lw1414/arc-fault-project/Block Diagrams/arcfault-firmware.png

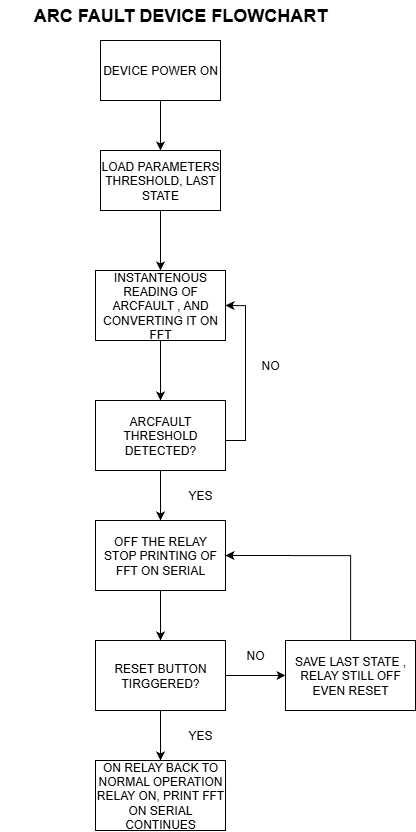
Block Diagrams/arcfault-firmware.png
