lw1414/arc-fault-project/Block Diagrams/arcfault-hardware block.png

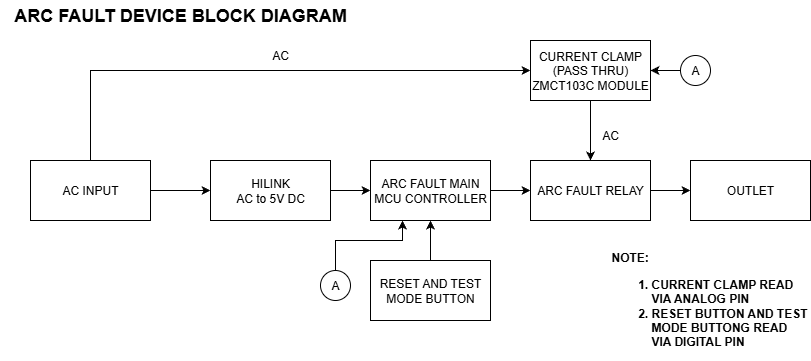
Block Diagrams/arcfault-hardware block.png
