lw1414/arc-fault-project/Block Diagrams/arcfault-physical connection on AC.png

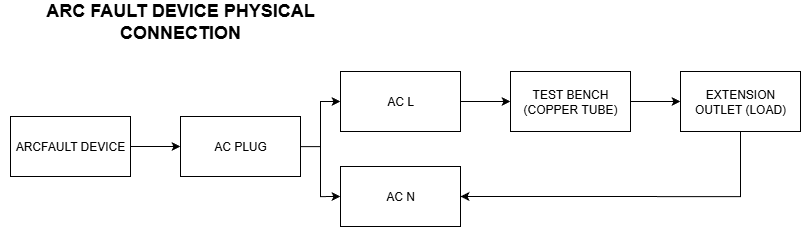
Block Diagrams/arcfault-physical connection on AC.png
