lw1414/arc-fault-project/Hardware/arc-fault - relay/EASYEDA_MODELS/RELAY-TH_L19.2-W15.6-H15.8.step

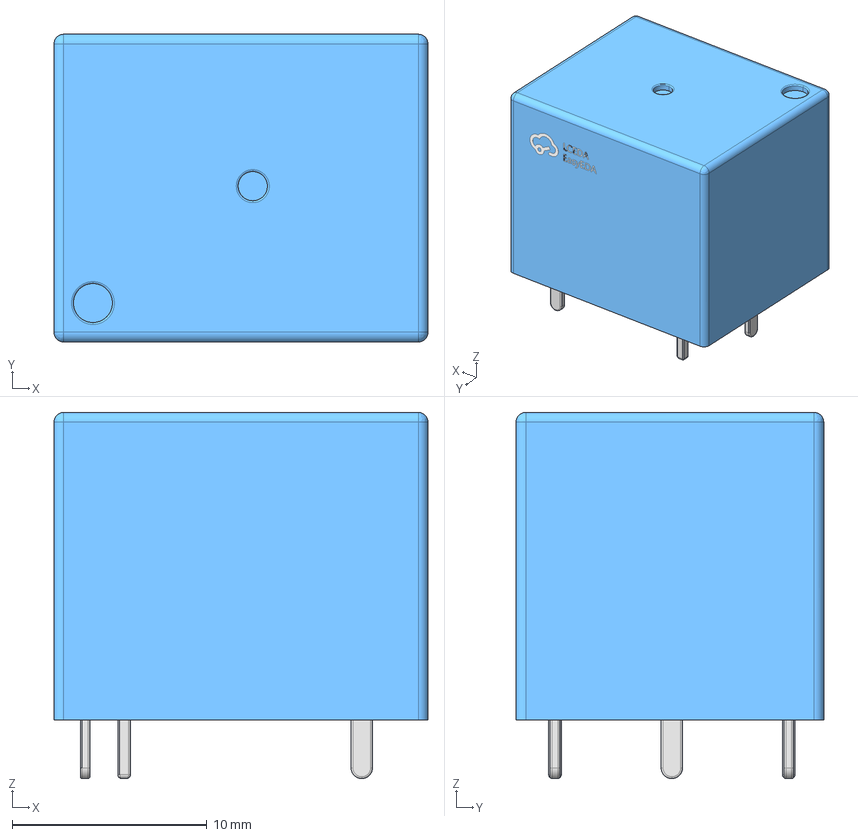
[picture p4: CAD file, 2025-11-20]
Hardware/arc-fault - relay/EASYEDA_MODELS/RELAY-TH_L19.2-W15.6-H15.8.step
19.2 x 15.8 x 18.8 mm
