lw1414/arc-fault-project/Hardware/arc-fault-main/EASYEDA_MODELS/PWRM-TH_HLK-5M05.step

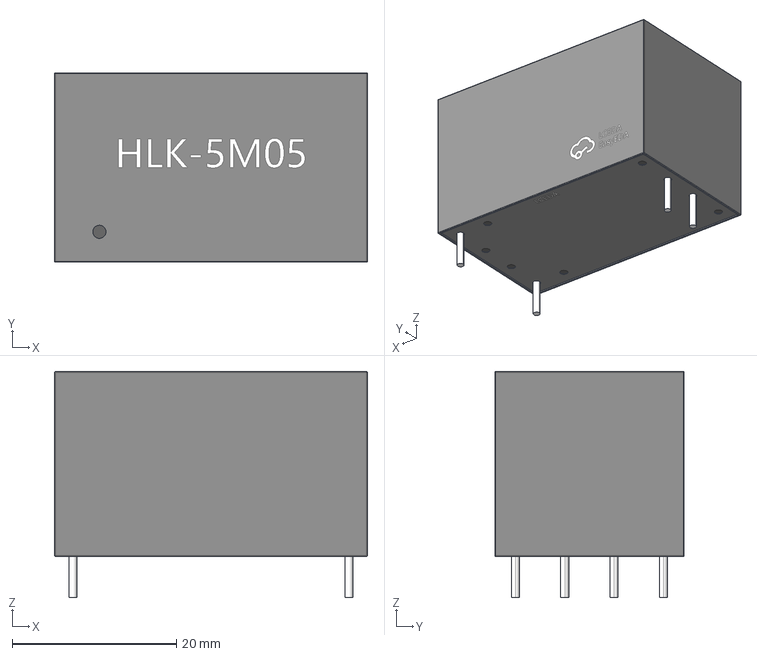
[picture p5: CAD file, 2025-11-20]
Hardware/arc-fault-main/EASYEDA_MODELS/PWRM-TH_HLK-5M05.step
38.1 x 23.1 x 27.5 mm
