lw1414/arc-fault-project/Hardware/arc-fault-miniboard/arc-fault-miniboard-UPDATED.step

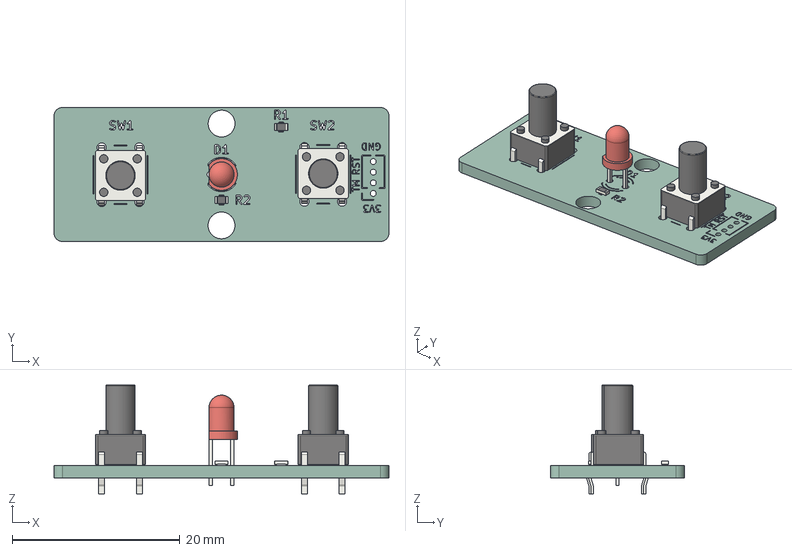
[picture p6: CAD file, 2025-11-20]
Hardware/arc-fault-miniboard/arc-fault-miniboard-UPDATED.step
40.0 x 16.0 x 13.0 mm
SW_PUSH_6mm_H9.5mm x 2
R_0603_1608Metric x 2
LED_D3.0mm
arc-fault-miniboard_silkscreen
arc-fault-miniboard_PCB
