lw1414/arc-fault-project/Hardware/arc-fault-main/EASYEDA_MODELS/USB-C-SMD_TYPE-C16PIN.step

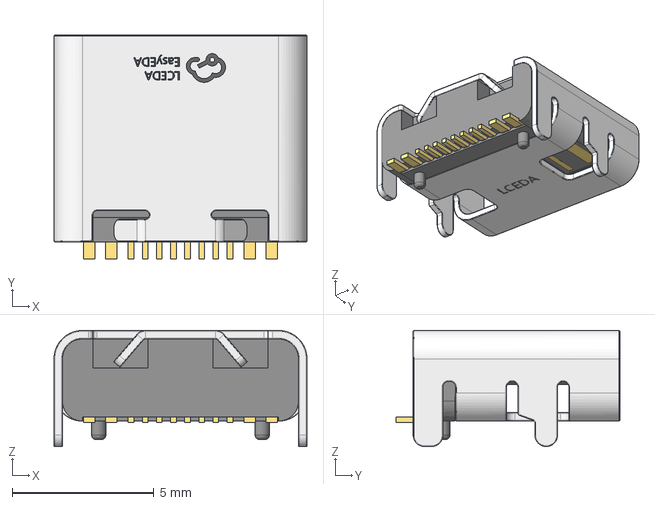
[picture p7: CAD file, 2025-11-20]
Hardware/arc-fault-main/EASYEDA_MODELS/USB-C-SMD_TYPE-C16PIN.step
8.94 x 7.90 x 4.10 mm
