lw1414/arc-fault-project/Hardware/arc-fault - relay/EASYEDA_MODELS/PC817X2NIP1B_SHP.step

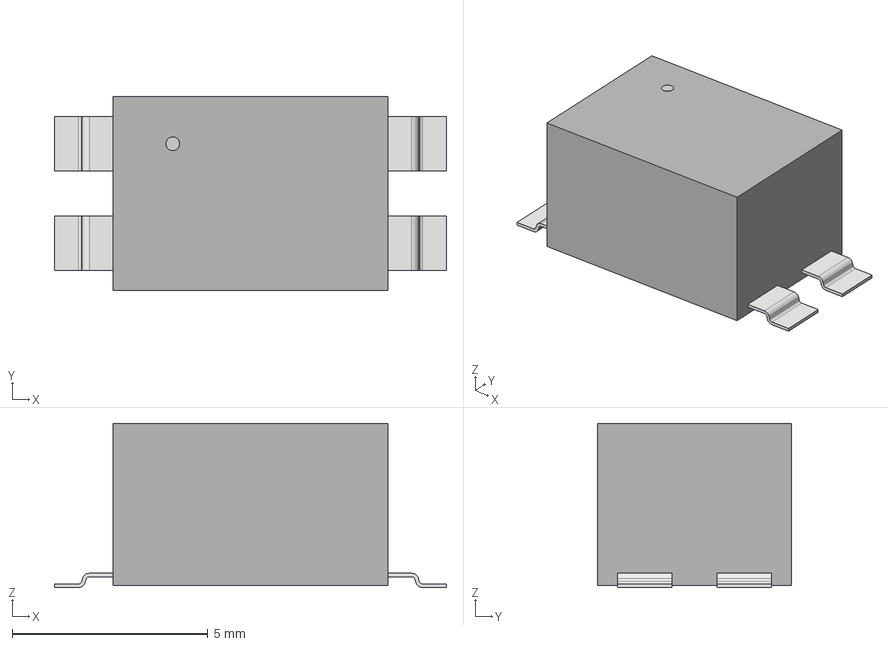
[picture p9: CAD file, 2025-11-20]
Hardware/arc-fault - relay/EASYEDA_MODELS/PC817X2NIP1B_SHP.step
10.0 x 4.95 x 4.19 mm
