lw1414/arc-fault-project/Hardware/arc-fault-main/EASYEDA_MODELS/RELAY-TH_G6A-274P-ST-US-DC5.step

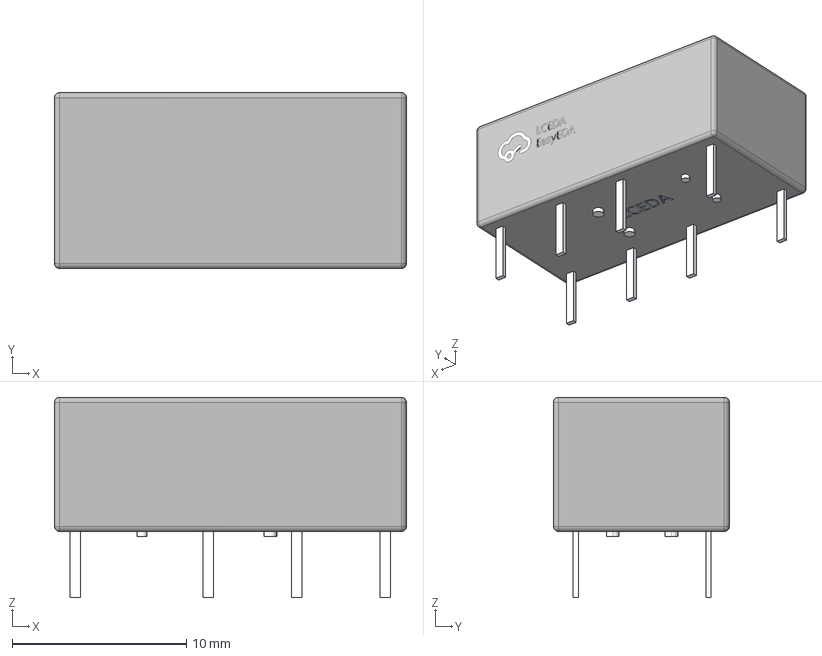
[picture p10: CAD file, 2025-11-20]
Hardware/arc-fault-main/EASYEDA_MODELS/RELAY-TH_G6A-274P-ST-US-DC5.step
20.2 x 10.1 x 11.5 mm
