lw1414/arc-fault-project/(list of files, cad)

Other CAD files:
Hardware/arc-fault-main/EASYEDA_MODELS/RELAY-TH_L19.2-W15.6-H15.8.step
