lw1414/arc-fault-project/Schematic/arc-fault -buttons-schematic.pdf

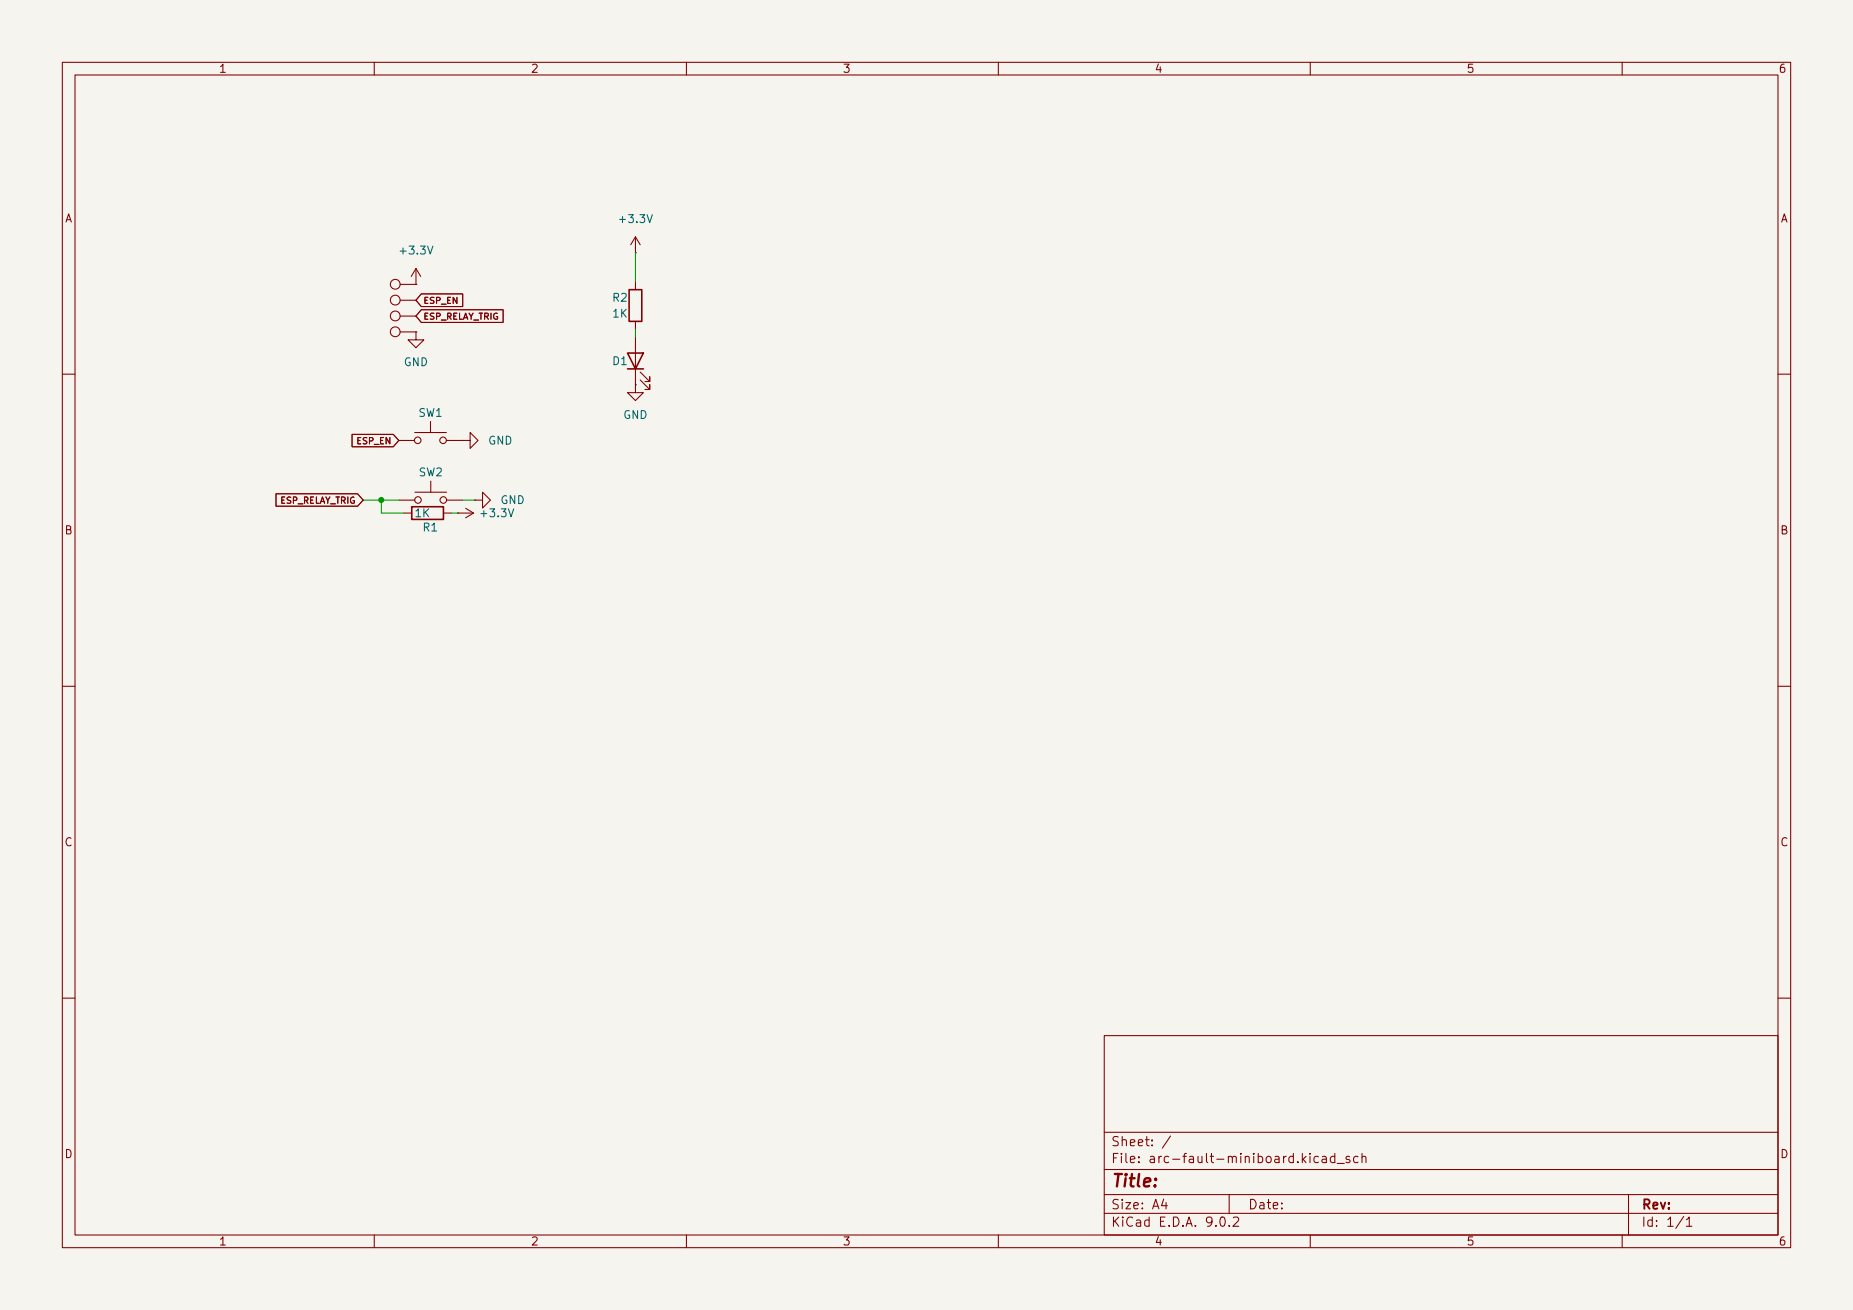
[picture p17: page 1]
