lw1414/arc-fault-project/Schematic/arc-fault -relay-schematic.pdf

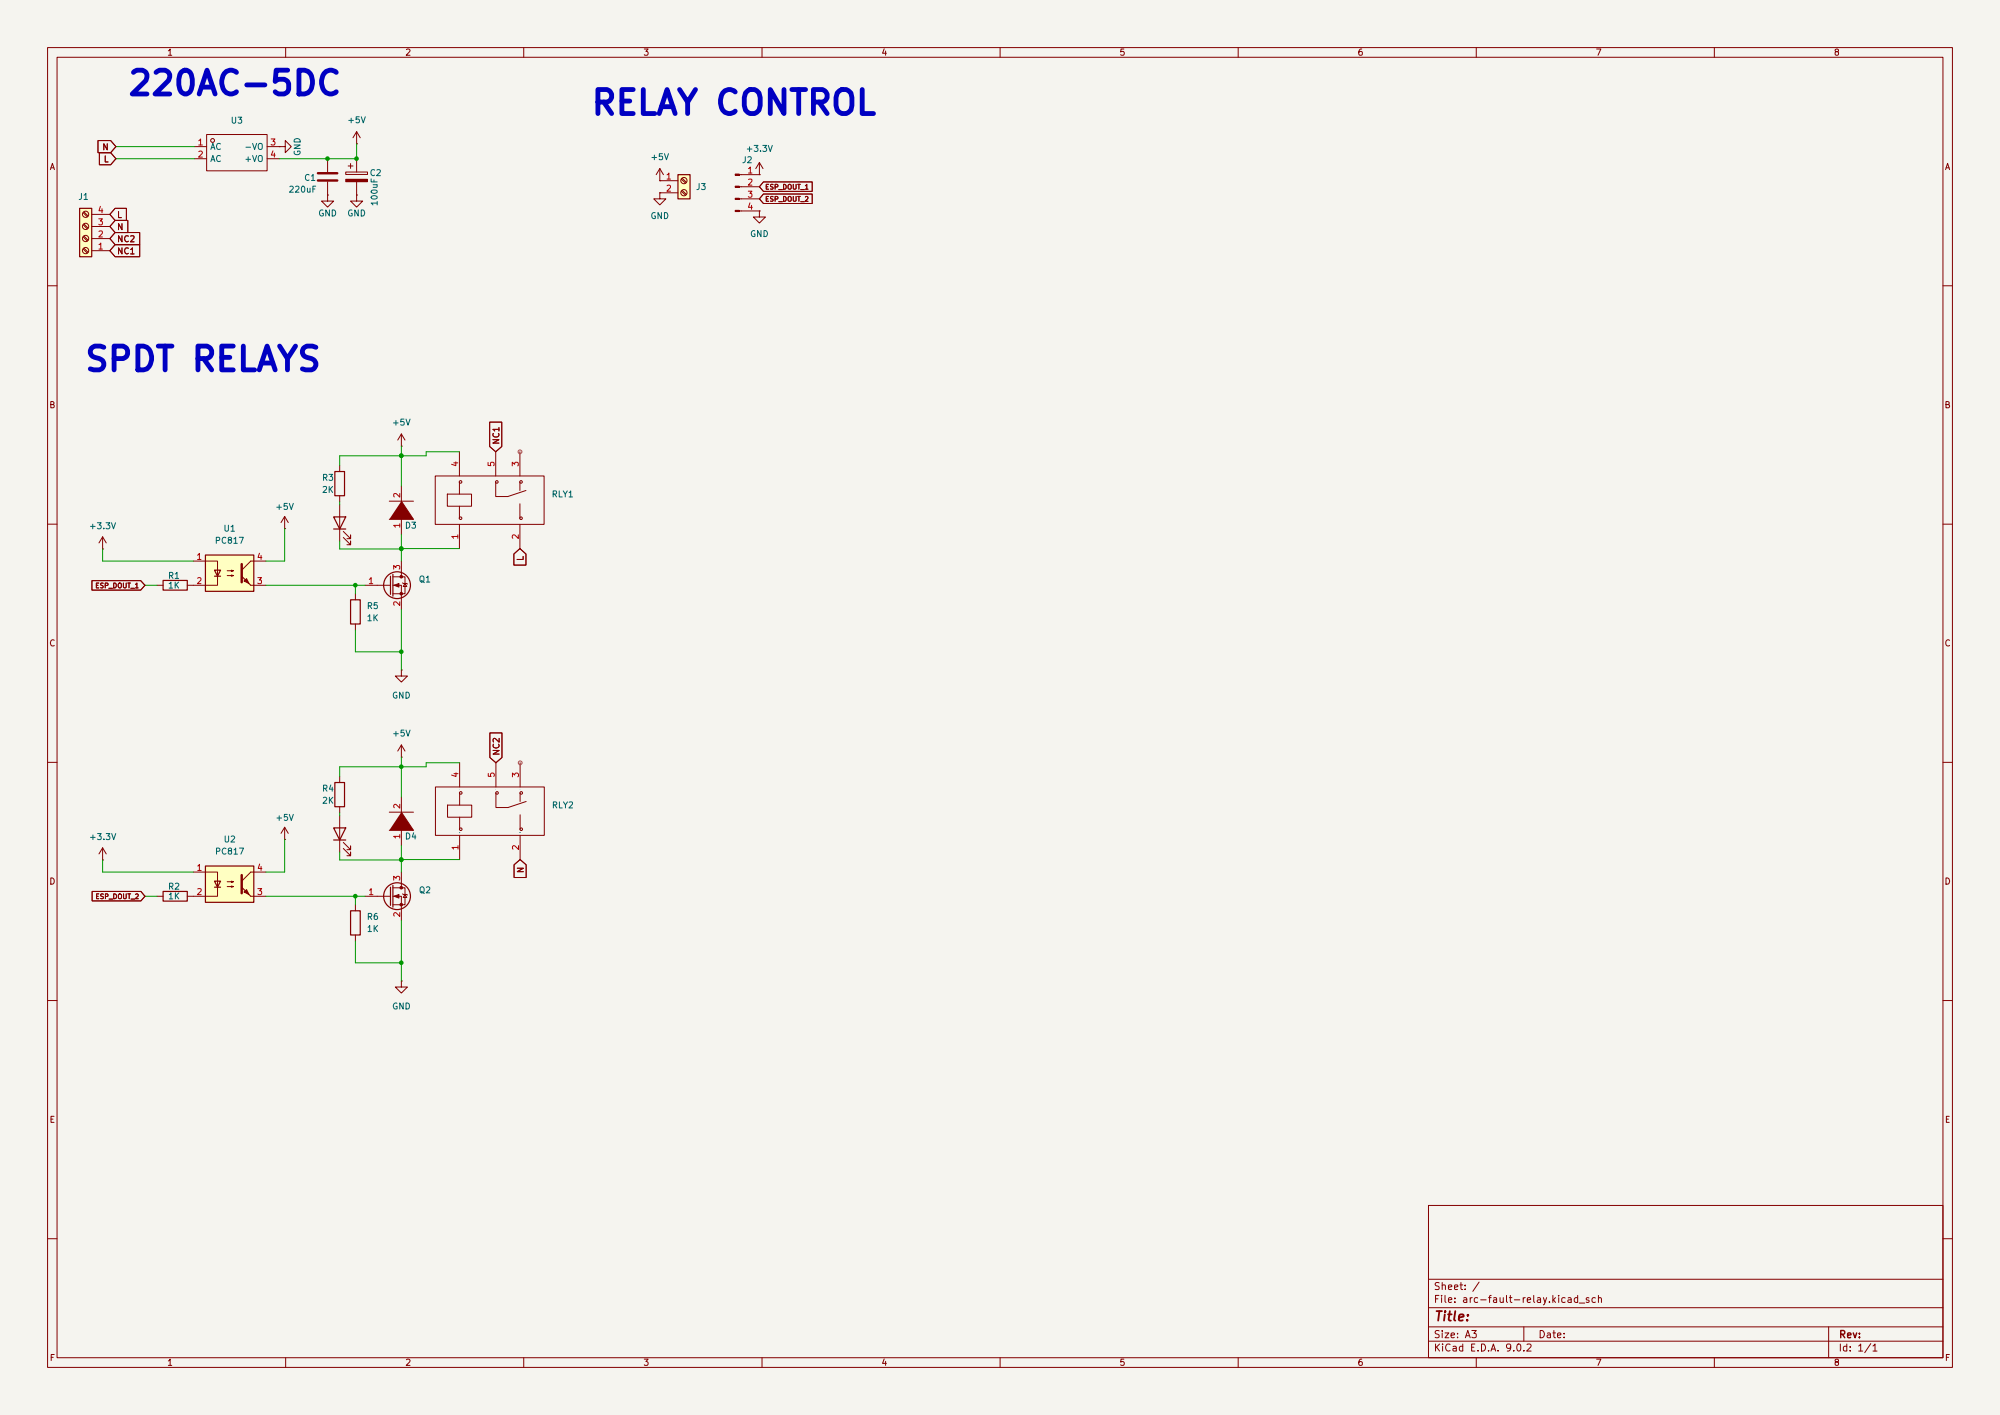
[picture p18: page 1]
