lw1414/arc-fault-project/Schematic/arc-fault-main-mcu-schematic.pdf

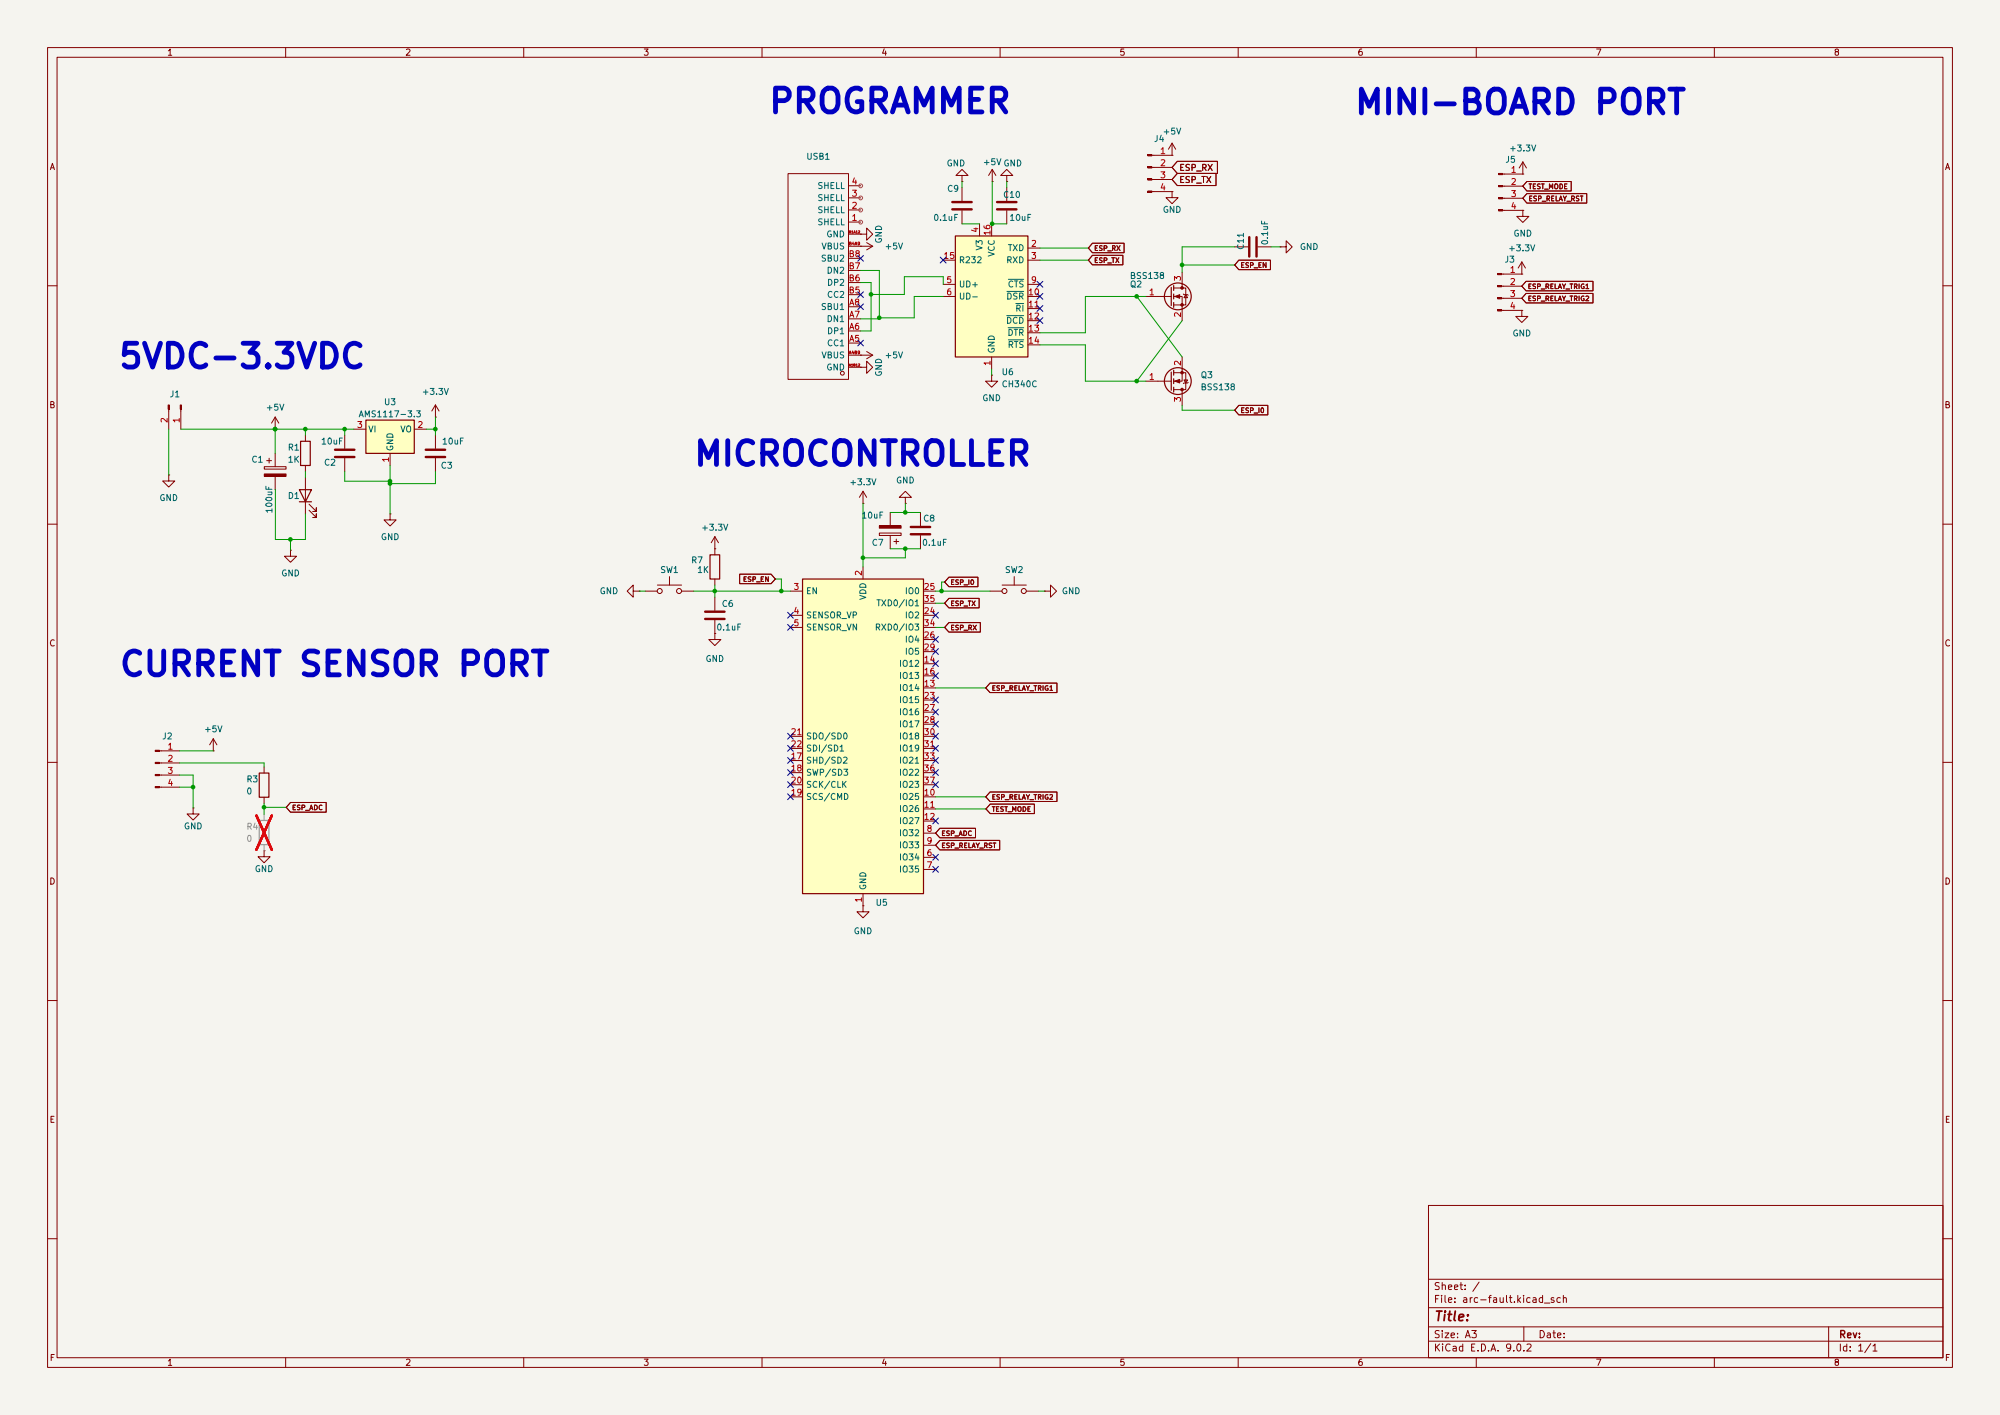
[picture p19: page 1]
