lw1414/arc-fault-project/Hardware/arc-fault - relay/arc-fault-relay.kicad_pcb

## KiCad design Hardware/arc-fault - relay/arc-fault-relay.kicad_pcb (2025-11-20)

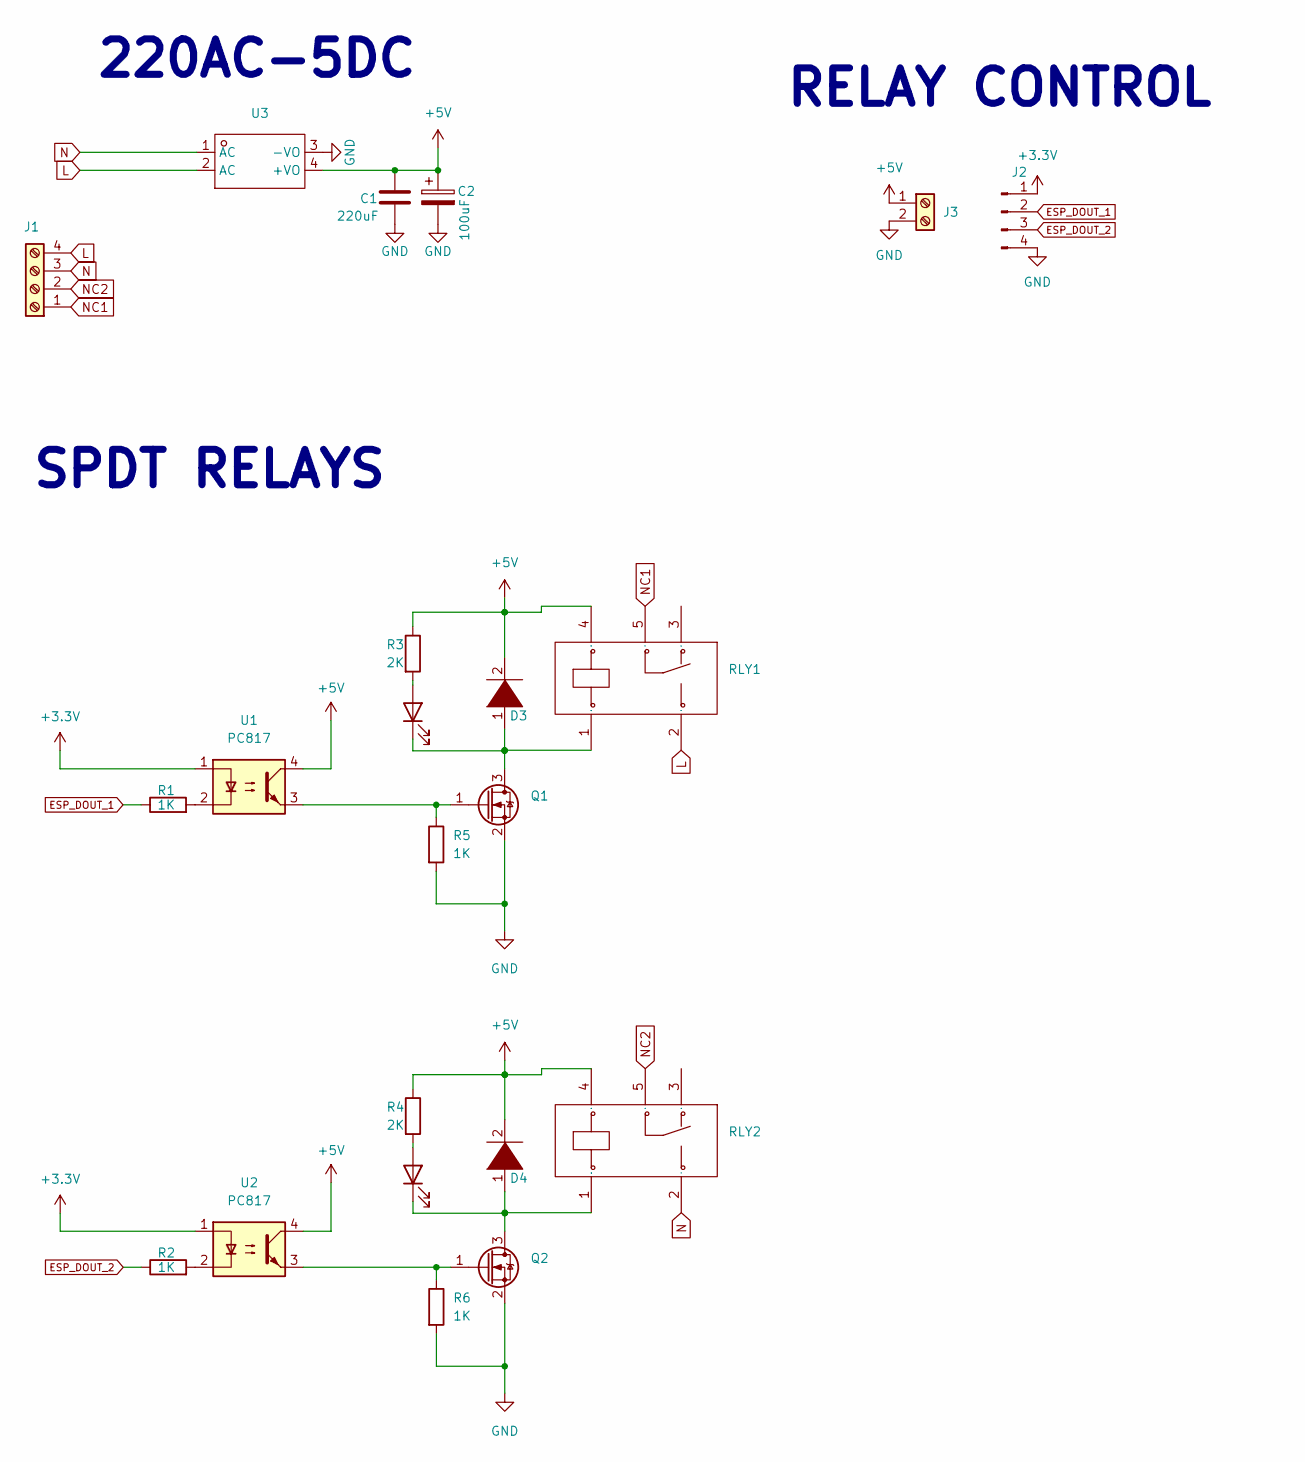
[picture p20: schematic arc-fault-relay.kicad_sch]

Parts:
C1: 220uF; C_1210_3225Metric_Pad1.33x2.70mm_HandSolder; LCSC C469553
C2: 100uF; C_0805_2012Metric_Pad1.18x1.45mm_HandSolder; LCSC C141660
D1, D2: LED; LED_0805_2012Metric_Pad1.15x1.40mm_HandSolder; LCSC C2297
D3, D4: 1N4001; D_SOD-123F; LCSC C2892326
J1: Screw_Terminal_01x04; Samtec_HPM-04-01-x-S_Straight_1x04_Pitch5.08mm
J2: Conn_01x04_Pin; PinHeader_1x02_P2.54mm_Vertical
J3: PinHeader_1x02_P2.54mm_Vertical
Q1, Q2: Q_NMOS_Depletion_GSD; SOT-23-3; LCSC C75882
R1, R2, R5, R6: 1K; R_0603_1608Metric_Pad0.98x0.95mm_HandSolder; LCSC C21190
R3, R4: 2K; R_0603_1608Metric_Pad0.98x0.95mm_HandSolder; LCSC C22975
RLY1, RLY2: RELAY-TH_SRD-XXVDC-XL-C; Manufacturer Part SRD-05VDC-SL-C; LCSC Part Name 蓝色 单组转换型继电器
U1, U2: PC817; APC-817xx-SL_AMB; LCSC C66405
U3: PWRM-TH_HLK-5M05; Manufacturer Part HLK-5M05; LCSC Part Name 5W超小型系列模块电源

Connections:
+3.3V: J2.1, U1.1, U2.1
+5V: C1.1, C2.1, D3.2 (A), D4.2 (A), J3.1, R3.1, R4.1, RLY1.4, RLY2.4, U1.4, U2.4, U3.4 (+VO)
ESP_DOUT_1: J2.2, R1.1
ESP_DOUT_2: J2.3, R2.1
GND: C1.2, C2.2, J2.4, J3.2, Q1.2 (S), Q2.2 (S), R5.2, R6.2, U3.3 (-VO)
L: J1.4, RLY1.2, U3.2 (AC)
N: J1.3, RLY2.2, U3.1 (AC)
NC1: J1.1, RLY1.5
NC2: J1.2, RLY2.5
unnamed: D1.2 (A), R3.2
unnamed: D1.1 (K), D3.1 (K), Q1.3 (D), RLY1.1
unnamed: D2.2 (A), R4.2
unnamed: D2.1 (K), D4.1 (K), Q2.3 (D), RLY2.1
unnamed: Q1.1 (G), R5.1, U1.3
unnamed: Q2.1 (G), R6.1, U2.3
unnamed: R1.2, U1.2
unnamed: R2.2, U2.2

Notes on the sheet:
220AC-5DC
RELAY CONTROL
SPDT RELAYS

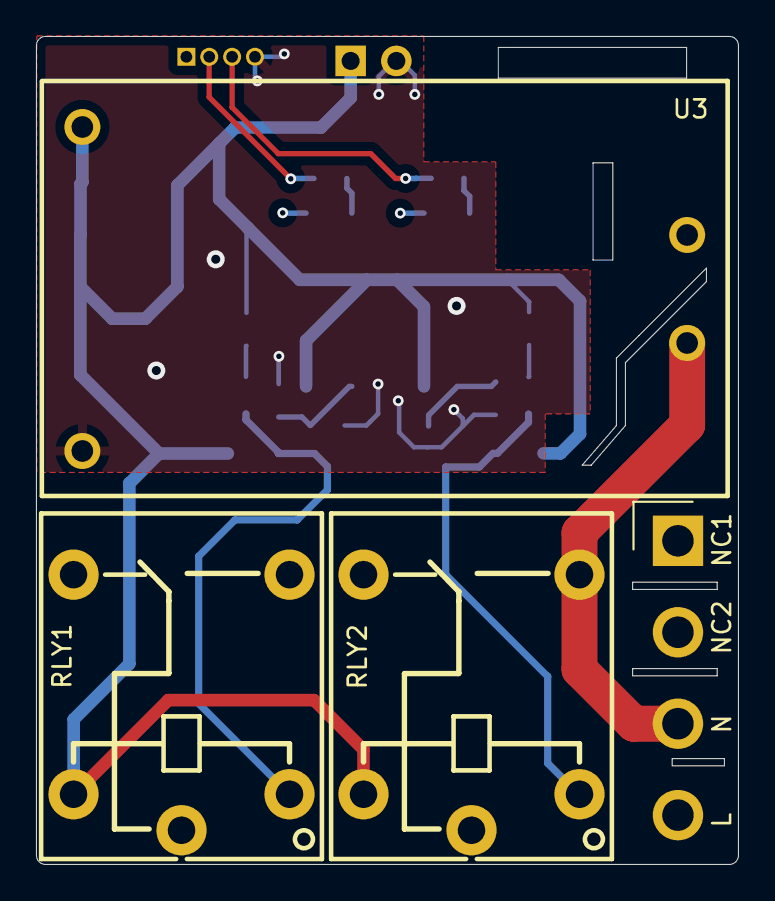
[picture p21: board arc-fault-relay.kicad_pcb from above]

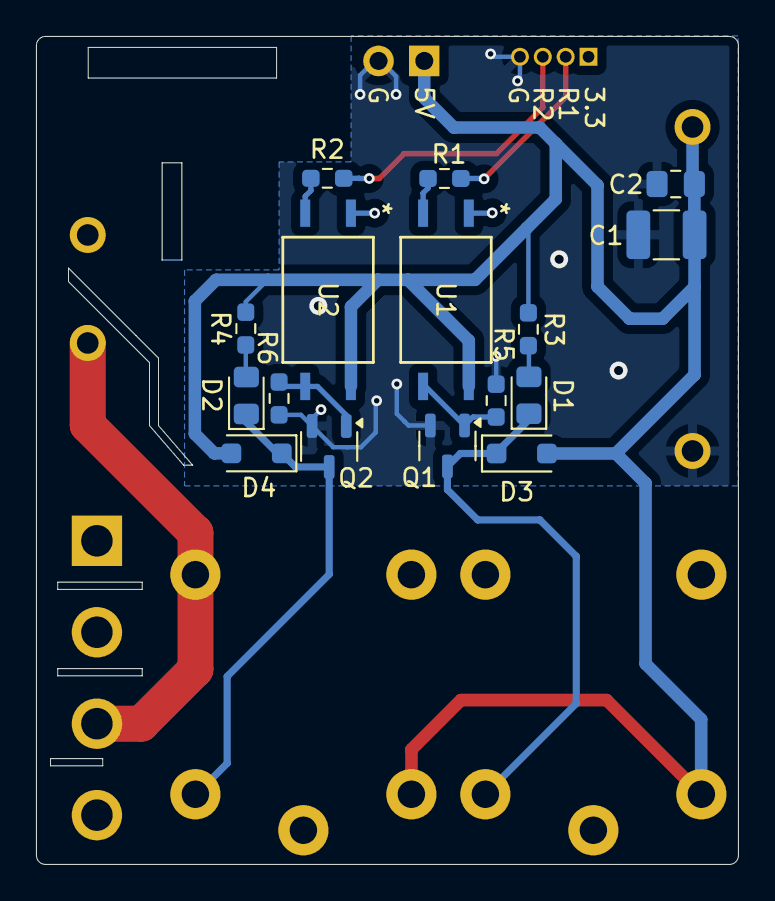
[picture p22: board arc-fault-relay.kicad_pcb from below]

Board: 4 copper layers, 39.0 x 46.0 mm, 22 parts (16 on the bottom side), 17 nets.
