lw1414/arc-fault-project/Hardware/arc-fault-miniboard/arc-fault-miniboard.kicad_pcb

## KiCad design Hardware/arc-fault-miniboard/arc-fault-miniboard.kicad_pcb (2025-11-20)

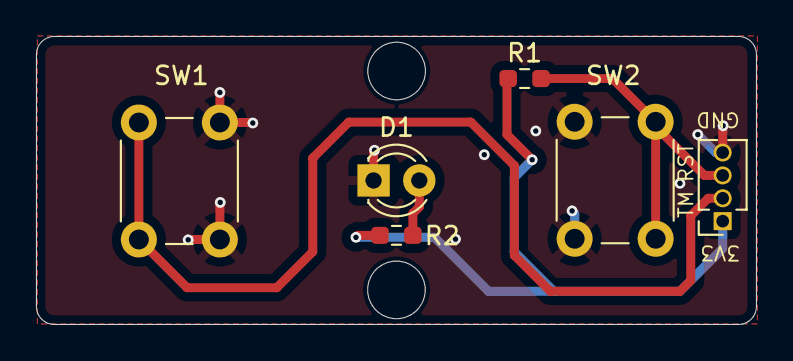
[picture p23: board arc-fault-miniboard.kicad_pcb from above]

Board: 2 copper layers, 40.0 x 16.0 mm, 6 parts (0 on the bottom side), 5 nets.

Parts:
D1: LED; LED_D3.0mm
J5: Conn_01x04_Pin; PinSocket_1x04_P1.27mm_Vertical
R1, R2: 1K; R_0603_1608Metric_Pad0.98x0.95mm_HandSolder
SW1, SW2: SW_Push; SW_PUSH_6mm_H9.5mm

Connections:
+3.3V: J5.1, R1.2, R2.1
ESP_EN: J5.2, SW1.1
ESP_RELAY_TRIG: J5.3, R1.1, SW2.1
GND: D1.1 (K), J5.4, SW1.2, SW2.2
unnamed: D1.2 (A), R2.2
