lw1414/arc-fault-project/(commit log)

2025-11-20 block diagram ,flowchart and physical connection
2025-11-21 - added schematic
